revolutionscan/ScanRig_V.1.0/Pictures/_Main_comp_101275.png

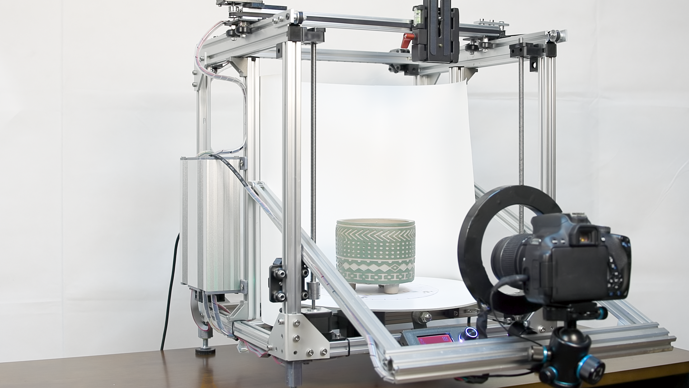
Pictures/_Main_comp_101275.png
