revolutionscan/ScanRig_V.1.0/README.md

# ScanRig_V.1.0
Open source files for photogrammetry rig.
