revolutionscan/ScanRig_V.1.0/Mechanical_Drawings/ScanRig_Front_v1.jpg

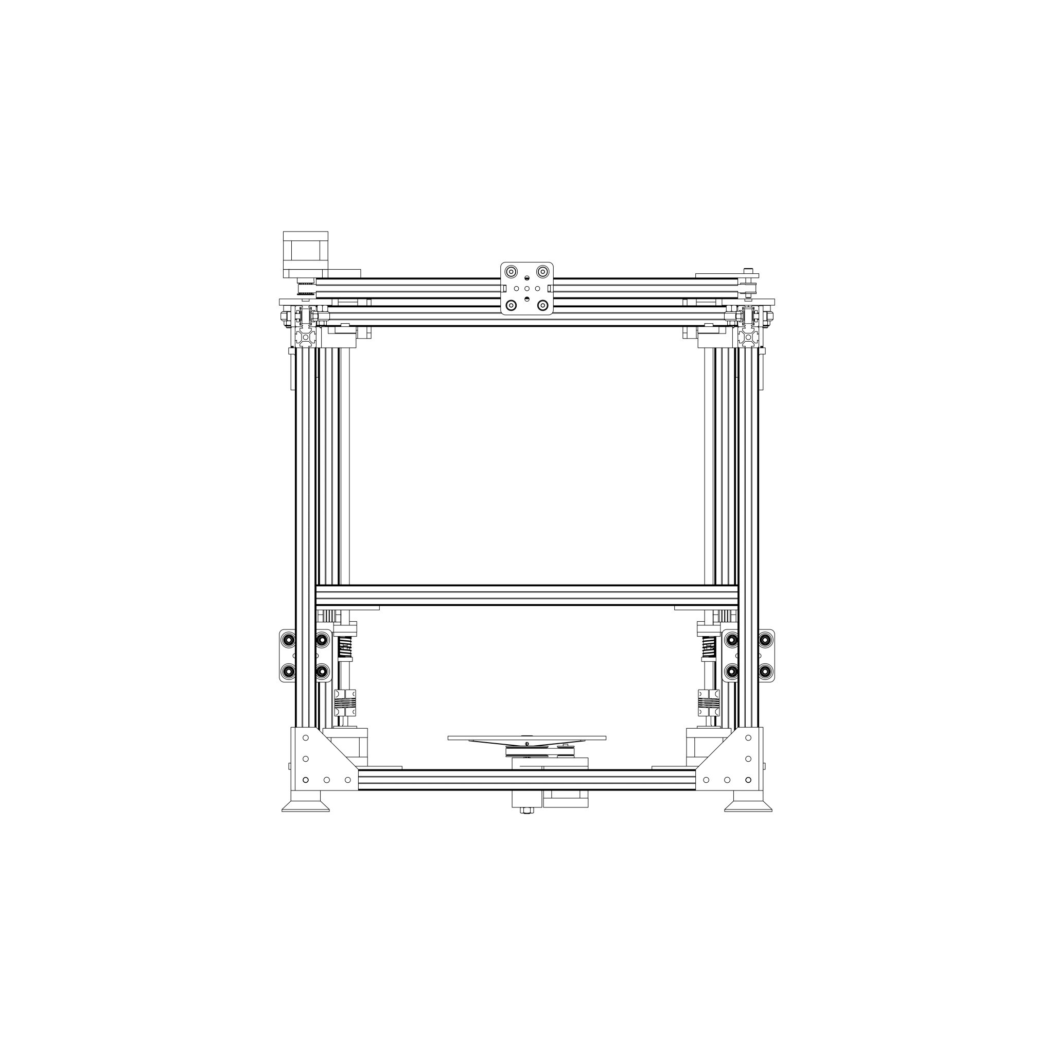
Mechanical_Drawings/ScanRig_Front_v1.jpg
