revolutionscan/ScanRig_V.1.0/Mechanical_Drawings/ScanRig_Top_v1.jpg

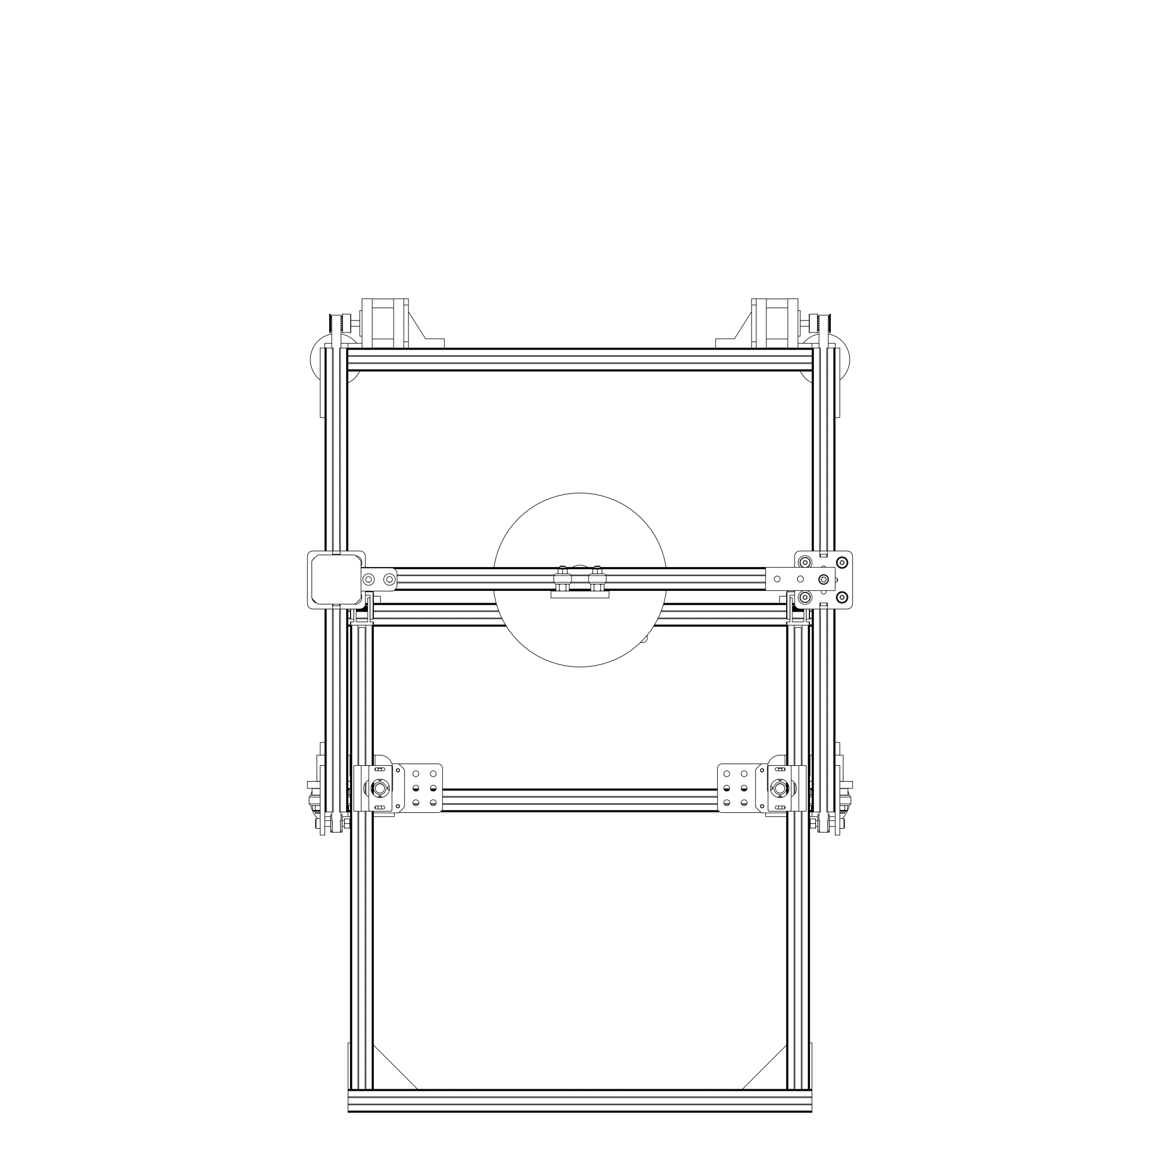
Mechanical_Drawings/ScanRig_Top_v1.jpg
