revolutionscan/ScanRig_V.1.0/Pictures/_Main_comp_1_01568.png

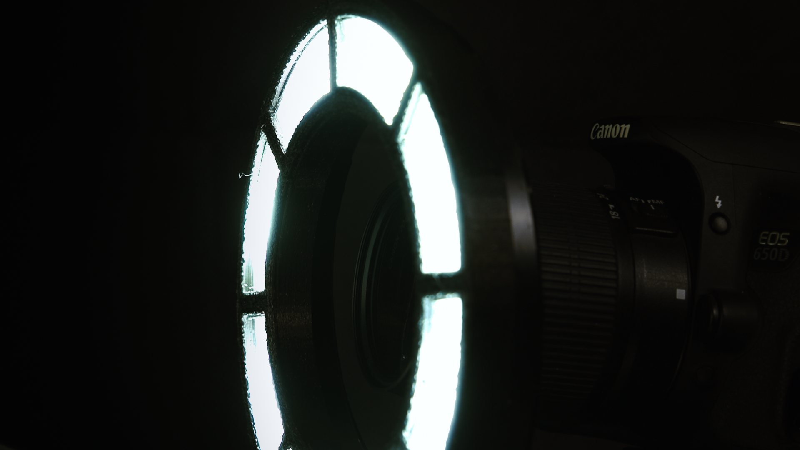
Pictures/_Main_comp_1_01568.png
