revolutionscan/ScanRig_V.1.0/Pictures/_Main_comp_100993.png

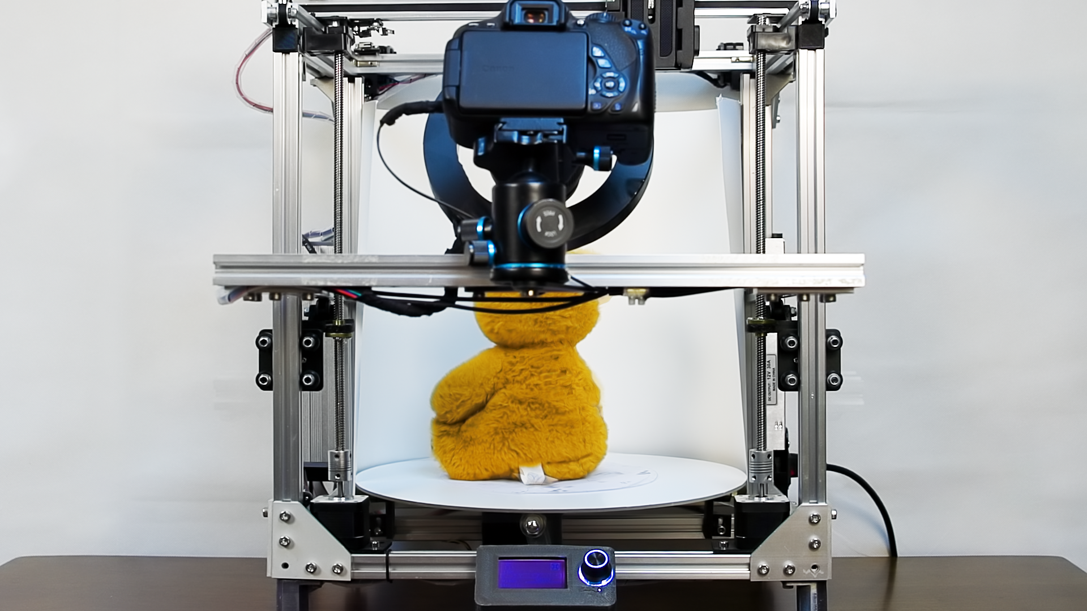
Pictures/_Main_comp_100993.png
