revolutionscan/ScanRig_V.1.0/Pictures/IMG_20240118_113210370.jpg

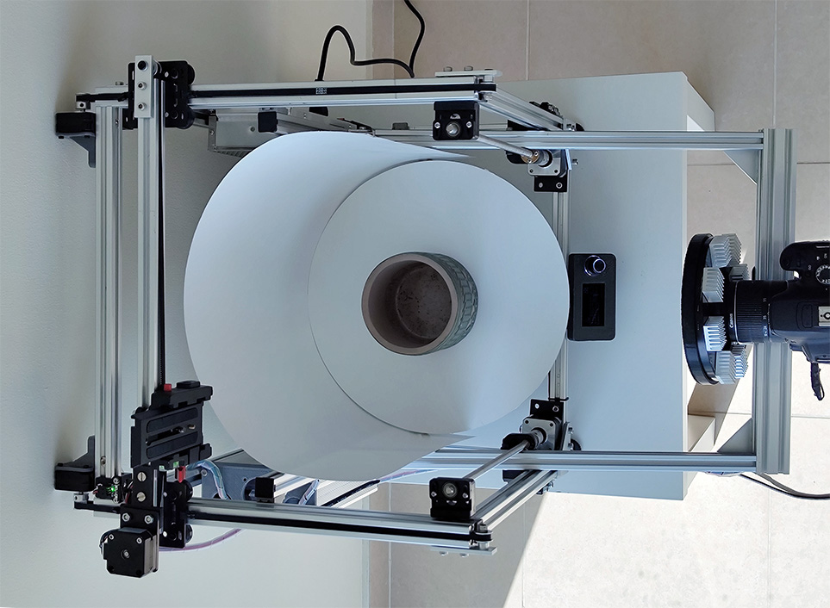
Pictures/IMG_20240118_113210370.jpg
