revolutionscan/ScanRig_V.1.0/Pictures/IMG_20240118_113330454.jpg

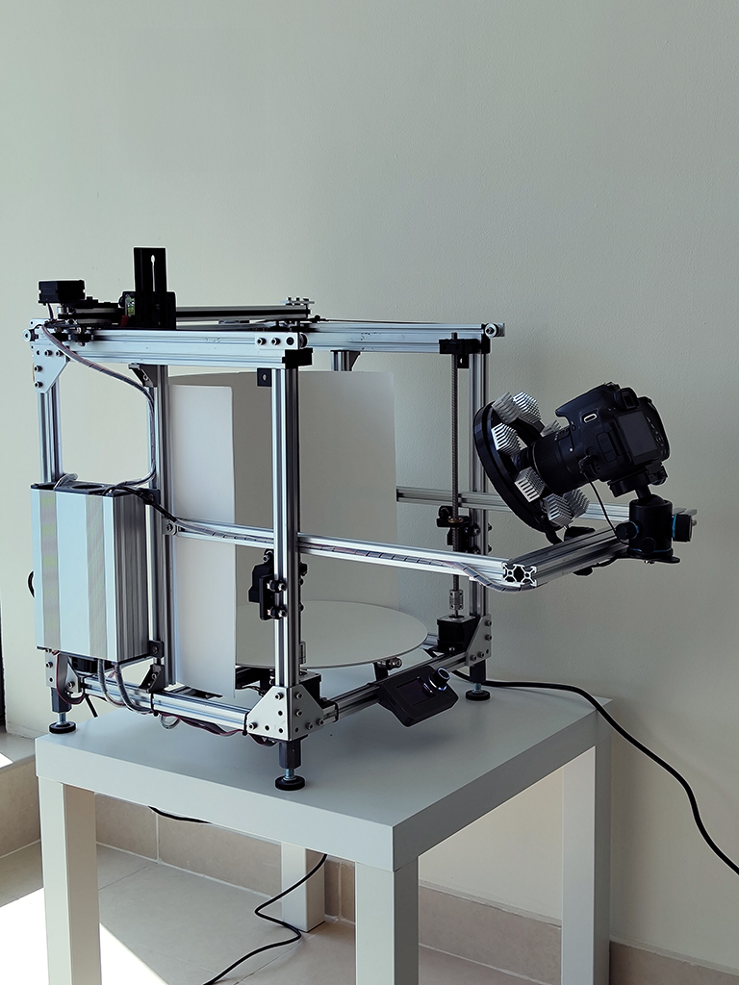
Pictures/IMG_20240118_113330454.jpg
