revolutionscan/ScanRig_V.1.0/ScanRig_BOM_v3.xlsx

Mechanics |  |  | Comment
2020 extrusion | 400mm | 16 | Missing one 2020 for 2.5D (Extrusion needs to be tapped for installing z axis pivot points) | https://www.aliexpress.com/item/1005004324352655.html | For the Z-axis camera arm, you might want to replace one 2020 with 2040 for extra rigidity for larger camera setups like with an AR400 flash.
2040 extrusion | 400mm | 2 |  | https://www.aliexpress.com/item/1005004324352655.html
2020 extrusion 5 hole 90 degree corner plate |  | 12 |  | https://www.aliexpress.com/item/1005004933978642.html
2020 corner bracket |  | 2 |  | https://www.aliexpress.com/item/1005001606267885.html
2020 inner corner bracket |  | 2 |  | https://www.aliexpress.com/item/4000795102417.html
2020 flexible pivot joint |  | 2 |  | https://www.aliexpress.com/item/1005004820583705.html
2020 nema 17 stepper motor mount |  | 2 |  | https://www.aliexpress.com/item/1005001860047581.html
2020 nema 17 stepper motor mount |  | 1 |  | https://www.aliexpress.com/item/1005001860047581.html
8 mm lead screw | 450mm | 2 |  | https://www.aliexpress.com/item/32970128435.html
8mm lead screw top mount |  | 2 |  | https://www.aliexpress.com/item/1005004359534458.html
5mm/8mm lead screw coupler |  | 2 |  | https://www.aliexpress.com/item/1005005114598745.html
2020 gantry plate wheel |  | 2 |  | https://www.aliexpress.com/item/1005001835688133.html
2020 gantry plate wheel |  | 3 |  | https://www.aliexpress.com/item/1005001835688133.html
CNC POM Wheel (big) + |  | 2 | For Z Carriage assembly | https://www.aliexpress.com/item/1005002846845515.html
GT2 timing pulley (bore 5mm, belt width 6mm, 20teeth) |  | 3 |  | https://www.aliexpress.com/item/1005004863292486.html
GT2 idler 20teeth 5mm |  | 3 |  | https://www.aliexpress.com/item/32822906447.html
GT2 timing belt | 5m | 1 | For clarification more than one meter is needed | https://www.aliexpress.com/item/32918948939.html
2020 Belt tensioner |  | 3 |  | https://www.aliexpress.com/item/1005004532578843.html
M5 T type insert | Pack 50 | 1 |  | https://www.aliexpress.com/item/32821764328.html
M5 sliding insert | Pack 50 | 1 |  | https://www.aliexpress.com/item/1005002114332413.html | Ball spring t-nuts are slightly more expensive but are MUCH easier to work than either the standard T-nuts or the hammerhead T-nuts, since they stay in place and can be inserted without having access to the open end of the extrusion:
M5 Machine Legs | Pack of 4 | 1 | Standoff legs for height adjustments and leveling | https://www.aliexpress.com/item/1005006793466745.htm
M5 Din 912 screw | 8mm | 24 | Added more M5 Screws 10(motors) + 3(endstops) + 8(legs) + 3(platform support) | https://www.aliexpress.com/item/32810872544.html
M5 Din 912 screw | 16mm | 8 | For attaching Z Carriage to gantry wheel plate
M5 Din 912 screw | 25mm | 3 | Added two for Z Carriage assembly wheel | https://www.aliexpress.com/item/32810872544.html
M5 Locking nut |  | 5 | For Z Carriage assembly wheel and platform support | https://www.aliexpress.com/item/1005006056776911.html
M8 Screw | 50mm | 1 | Rotary Assembly
M8 Screw | 20mm | 1 | Platform Support
M8 washer |  | 2 | Rotary Assembly
M8 Nyloc nut |  | 1 | Rotary Assembly
M3 Screw | 40mm | 24 | For attaching motor to NEMA Bracket
M3x14mm + nuts | 14mm | 12 | For attaching Z Carriage to lead screw
160-2GT-80Teeth Timing Belt | 160mm | 1 | Couldn't find a set with 160mm belt | https://www.aliexpress.com/item/32829827298.html
GT2 Timing Belt Pulley Bearing 20 & 60 Teeth 5mm 8mm Bore With 200mm Width 6mm Belt 1:3 Reduction |  |  | For Rotary Plate Assembly | https://www.aliexpress.com/item/1005005904948229.html
608Z Ball bearing | Pack 10 | 1 |  | https://www.aliexpress.com/item/1005006737960809.html
Electronics
Nema 17 stepper motor 42x42x38mm | 1.5A | 3 | Missing motor for rotary plate (2 for Z carriage + one for plate) | https://www.omc-stepperonline.com/e-series-nema-17-bipolar-0-9deg-30ncm-42-48oz-in-1-5a-42x42x38mm-4-wires-17me15-1504s
Nema 17 stepper motor 42x42x38mm | 1.5A | 3 |  | https://www.omc-stepperonline.com/e-series-nema-17-bipolar-0-9deg-30ncm-42-48oz-in-1-5a-42x42x38mm-4-wires-17me15-1504s
3d printer endswitches | pack of 3 | 1 |  | https://www.aliexpress.com/item/1005001834951972.html
Dual Z Axis splitter adapter |  | 2 |  | https://www.aliexpress.com/item/1005001792345071.html
Makerbase MKS Gen_L 2.1 Control Board |  | 1 |  | https://www.aliexpress.com/item/32802151924.html
TMC2209 Stepper motor driver (optional for silent operation) |  | 4 |  | https://www.aliexpress.com/item/1005005260961560.html
Power
LED power supply 12V/10A |  | 1 |  | https://www.aliexpress.com/item/33051556213.html
Buck converter 4-40V |  | 1 |  | https://www.amazon.com/EPLZON-Converter-Voltmeter-1-25-37V-Adjustable/dp/B09R49R76K
Mosfet module IRF520 |  | 2 |  | https://www.aliexpress.com/item/32836126224.html
Aluminum Enclosure 150*38*205mm Split Box PCB Silver OR |  |  | Box for electronics | https://www.aliexpress.com/item/1005005463240122.html
Aluminum Project Box Aluminum Cooling Box Aluminum Enclosure PCB Instrument Cooling Box Electronic Project Case 4*14*200mm |  |  | Alt Box for electronics | https://www.aliexpress.com/item/1005006534091460.html
Power Supply Mount |  |  |  | https://www.thingiverse.com/thing:2491547 | https://www.thingiverse.com/thing:3138130
Power supply outlet (depending on the type) |  |  |  | https://www.aliexpress.com/item/1005006361356458.html
Suggested Camera Mounts
DSLR Camera Tripod Ball Head |  |  |  | https://www.amazon.com/TH3-Capacity-U-Shaped-Switching-Vertical/dp/B00MGJH5U6/ref=sr_1_2
Bracket Extension Bar Flat or L Shaped |  |  | For mounting front camera | https://www.amazon.com/FANAUE-CQL-01-Universal-Compatible-Arca-Swiss/dp/B0CN4BQLRV/ref=sr_1_34
DSLR Camera L Bracket Vertical |  |  |  | https://www.amazon.com/Vertical-Horizontal-Switching-Compatible-Stabilizer/dp/B09RB11GK5/ref=sr_1_1
