revolutionscan/ScanRig_V.1.0/STL/3D_Scanner/Platform_assembly_v1.stl

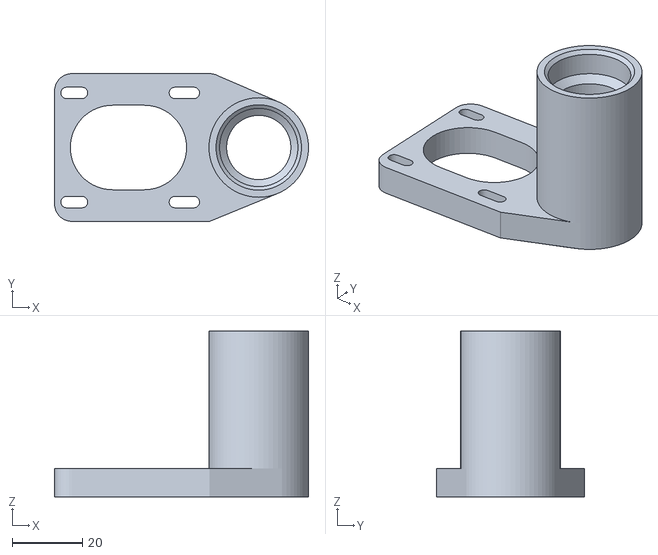
[picture p20: CAD file, 2024-03-21]
STL/3D_Scanner/Platform_assembly_v1.stl
72.1 x 42.0 x 47.0
