revolutionscan/ScanRig_V.1.0/STL/2.5D_Addition/X_motor_holder_v1.stl

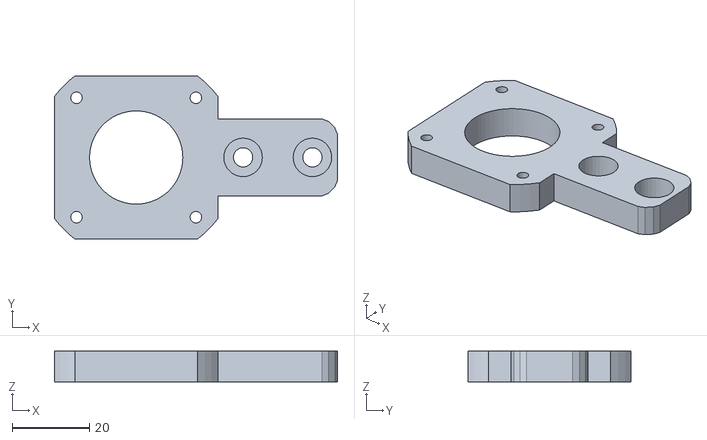
[picture p21: CAD file, 2024-03-21]
STL/2.5D_Addition/X_motor_holder_v1.stl
73.5 x 42.4 x 8.00
