revolutionscan/ScanRig_V.1.0/STL/3D_Scanner/Z_carriage_left_v1.stl

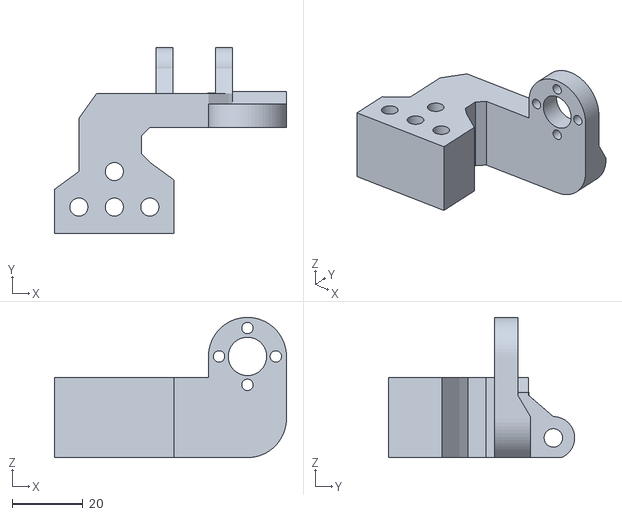
[picture p22: CAD file, 2024-03-21]
STL/3D_Scanner/Z_carriage_left_v1.stl
65.4 x 52.5 x 39.5
