revolutionscan/ScanRig_V.1.0/STL/Platform_Support_Right.stl

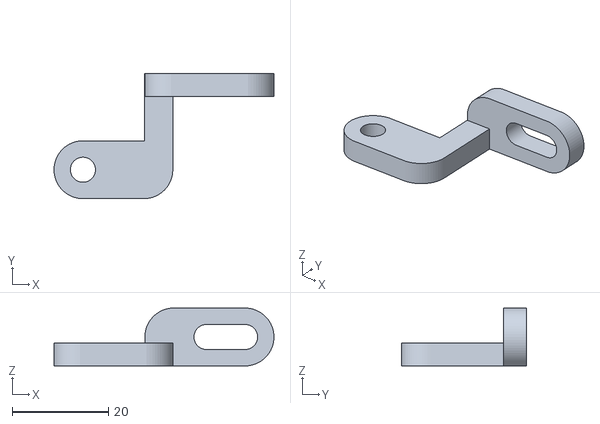
[picture p23: CAD file, 2024-08-19]
STL/Platform_Support_Right.stl
45.7 x 26.0 x 12.0
