revolutionscan/ScanRig_V.1.0/STL/2.5D_Addition/Y_motor_holder_x2_v1.stl

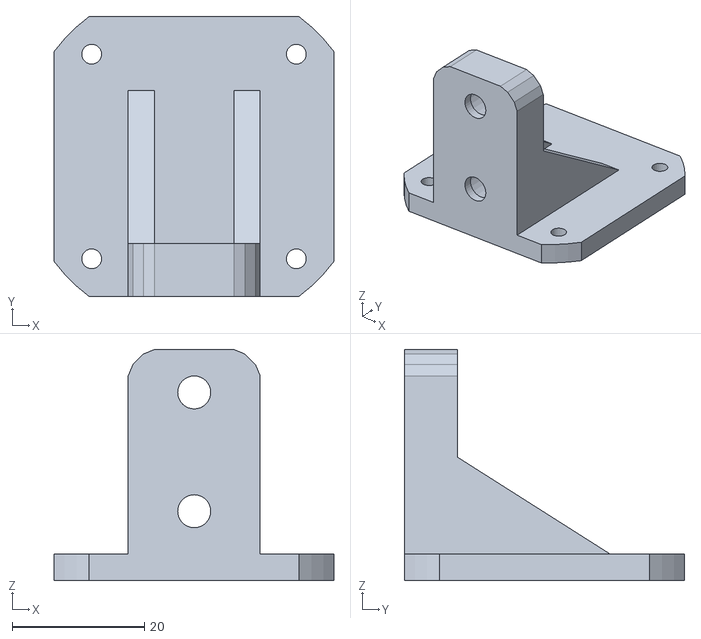
[picture p24: CAD file, 2024-03-21]
STL/2.5D_Addition/Y_motor_holder_x2_v1.stl
42.4 x 42.4 x 35.0
