revolutionscan/ScanRig_V.1.0/STL/3D_Scanner/Platform_carrier_v1.stl

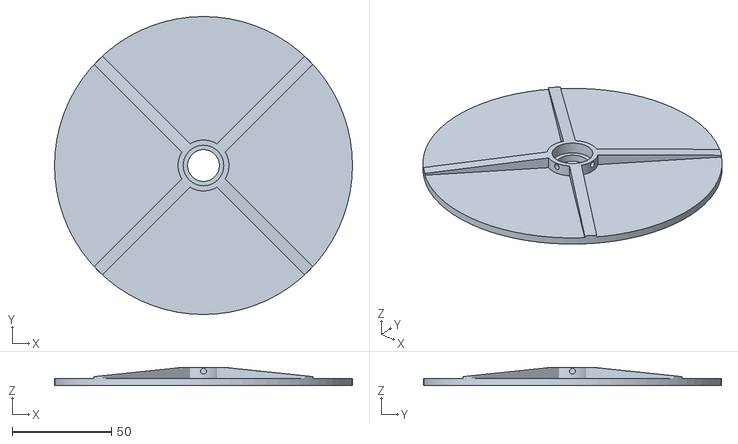
[picture p25: CAD file, 2024-03-21]
STL/3D_Scanner/Platform_carrier_v1.stl
150.0 x 150.0 x 9.30
