revolutionscan/ScanRig_V.1.0/STL/End_Stop_Switch_Holder.stl

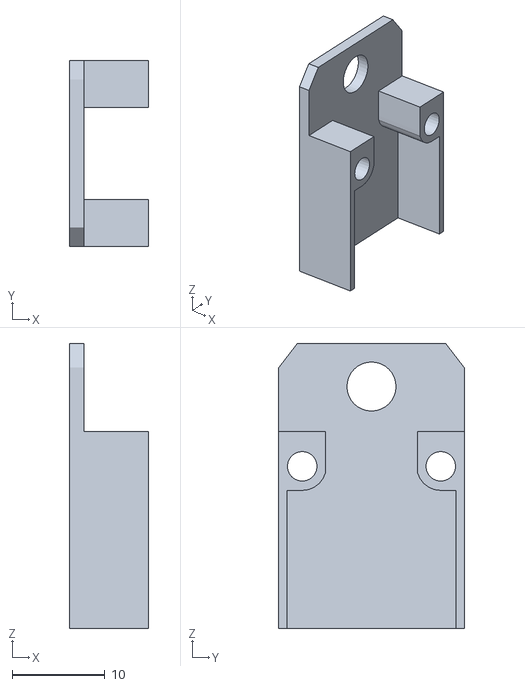
[picture p26: CAD file, 2024-08-19]
STL/End_Stop_Switch_Holder.stl
8.55 x 20.0 x 30.8
