revolutionscan/ScanRig_V.1.0/STL/Platform_Support_Front.stl

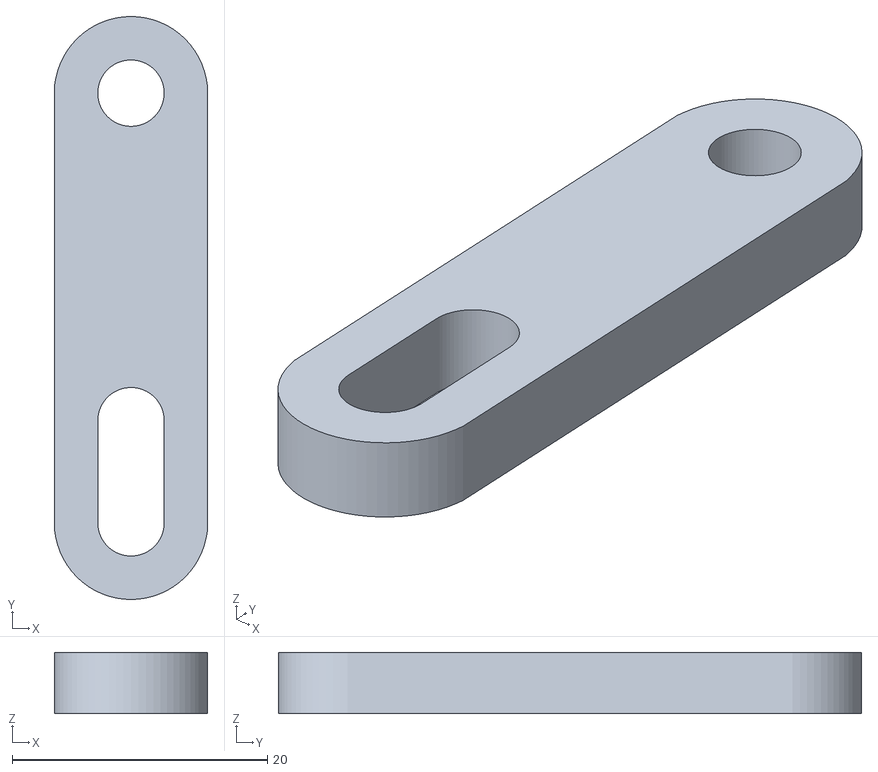
[picture p27: CAD file, 2024-08-19]
STL/Platform_Support_Front.stl
12.0 x 45.7 x 4.80
