revolutionscan/ScanRig_V.1.0/(list of files, cad)

Other CAD files:
STL/3D_Scanner/Z_carriage_right_v1.stl
STL/Platform_Support_Left.stl
