revolutionscan/ScanRig_V.1.0/(threads)

Thread 1 (2024-08-02):

More accurate BOM QTYs to avoid confusion

Packabilly, 2024-08-02:
Hi, my shipment of parts came today; I'm really excited to build my rig. However when I began assembly, I noticed I had made some errors when ordering parts due to confusion caused by the BOM referencing the quantities listed in the Aliexpress links instead of the true total part quantities.

For example, the 'inner corner bracket' QTY is listed as '2', but that references the Ali link QTY of 5pcs, so the true total QTY would be 10. The same for the corner brackets and the M5 screws.

It's not a huge deal if you read and understand the BOM and review the CAD properly, but I think changing to total QTYs would make it easier for dummies like me to understand and self-source parts, as well as prevent future issues caused by broken links.

Thanks or the awesome project; I can't wait to get it up and running!

revolutionscan, 2024-08-02:
Hi,
thank you for letting me know. I will update the BOM to avoid further
confusion.

Please share any images and if you need any assistance I'll be happy to
help you out.

Thanks!

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

Links:
------
[1] https://github.com/revolutionscan/ScanRig_V.1.0/issues/1
[2]
https://github.com/notifications/unsubscribe-auth/BHEKZ3BVWHBVWLBEY64KAX3ZPNAA3AVCNFSM6AAAAABL4DAN5GVHI2DSMVQWIX3LMV43ASLTON2WKOZSGQ2DINBQGI3TMOI

Thread 2 (2024-08-17):

My build experience: issues and suggestions

Packabilly, 2024-08-17:
Hey again! Firstly I just wanted to say thank you for the work you've done on the project thus far; there is nothing else like this out there and I hope you continue to develop and refine it. I hope my experiences below don't give the impression of complaining, I just want to offer my experience in the most constructive manner I can. Hopefully this helps improve the project or at least help other users avoid some pitfalls.

 I've started my build and progressed as far as possible and have encountered a few issues which I've noted along with a couple of suggestions to make the build process a little more straightforward. I've listed the critical stuff first to simplify it (sorry if the format is hard to read):

------------------------------------------------------------------------------------------------------------------------------------------
### Critical stuff that stop the build in it's tracks (I had a few things on hand but most users won't)- Missing/unclear BOM parts and STLs:

- Missing 2x smooth POM wheel and 2x Nyloc nuts from z-axis assembly;

These are crucial to the build but not listed in BOM

- Extrusion needs to be tapped for installing z axis pivot points;

This was an unforeseen issue, but something that should be made clear. I ended up using J-B Weld metal to epoxy them in place instead.

- Leadscrew brass nut screws did not self-tap like shown in guide;

I used M3x14mm + nuts to attach to printed assembly

- Attaching motors using NEMA mount plates needs M3x40 to attach securely;

Build guide shows long countersunk screws used, but would be better/easier to order M3x40 with the rest of the parts

- Missing M5x16 to attach gantry wheel plate to z-axis assembly;

Critical to the build and need to be the exact length to avoid interfering with the "gantry plate wheel"

- Missing motor for 2.5D;

Build guide implies 2x Y-Motors are used, but BOM only lists 5x motors, but 6 are needed: Y= 2x, X= 1x, Z= 2x, Rot= 1x

- Missing 2020 for 2.5D;

15x 2020 is one short. I ended up ordering an additional 2040 instead for the camera arm for extra rigidity

- Missing GT2 60 tooth pulley, 20 tooth pulley and belt + fasteners (M8x60 bolt, 2x flat washers, 1x split washer and 1x nut);

Critical to build, but not listed in BOM

- Missing STLs & BOM for legs/feet;

Critical to build, since the platform motor is mounted below the bottom extrusions

- Missing files for endstops

Critical to build

- STLs missing for platform supports +Nyloc nuts missing from BOM

Critical to build if you want to utilize the entire frame fro the platform

- BOM only lists 1M of GT2 timing belt

Critical to build if using 2.5D, since you'll need 3x lengths: 2x for Y and 1x for X. It would be simpler to add a total belt length for users to order and cut themselves

- Missing LCD from BOM and STL for mount

Critical for build since it provides an interface. I personally am going to use Klipper to interface via Weeb browser, but the average user will likely use an LCD.

- Missing links/STL for compatible camera carriers

Critical for build since there are many options for mounts out there. I personally have no idea what to use here.

- Missing STL/link for electronics enclosure and PSU mount

Critical to build and also for user safety. Without a mount, the PSU will have exposed mains wiring which is obviously pretty dangerous.

- Missing STL/link for electronics enclosure

Critical to build since the mainboard needs to be mounted in some way to prevent shorts on the metal frame.

- Missing M5x8 screws;

BOM lists 50x, which is just enough  to build the frame but not mount the motors

------------------------------------------------------------------------------------------------------------------------------------------
### Non-critical stuff that won't stop the build but may cause confusion:

- Missing 2x corner brace blocks from top-front extrusions;

These are shown in CAD and build guide but missing from BOM. I assume these are to be replaced  by "2020 inner corner bracket", but it stumped me at first.

- Linked corner brackets have alignment nubs that prevent them mounting flush with extrusions (for the z-axis pivot points);

I ground these flat with a Dremel tool so they sit flush

- Gantry wheel plate hole orientation doesn't match ali link, so is less rigid;

The X gantry wheel plate in the build guide has an extra hole closer to the belt mount points, but the linked ones do not. Not a big deal, but it may cause the X gantry to twist easier

------------------------------------------------------------------------------------------------------------------------------------------
### Suggestions to make the process simpler:

- Separate BOM section for 2.5D would help clarify;

Adding a separate section for the 2.5D components would make it ore clear to the user what is required and let them decide if they need/want 2.5D or just the Z-axis + rotary platform

- Add option to replace t-nuts with ball spring T-Nuts;

Ball spring t-nuts are slightly more expensive but are MUCH easier to work than either the standard T-nuts or the hammerhead T-nuts, since they stay in place and can be inserted without having access to the open end of the extrusion: https://www.aliexpress.com/item/1005003678960619.html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

- Add option to replace z-axis 2020 with 2040

For the Z-axis camera arm, it would be nice to offer the option to use 2040 instead of the BOM 2020 for extra rigidity for larger camera setups like with an AR400 flash.

------------------------------------------------------------------------------------------------------------------------------------------
### Extra stuff that should be in the BOM (this is not an exhaustive list, just what I can remember and have noted during my build):

- M3x14 =                x 4 (Rotary plate motor mount) + 4-8 (Leadscrew brass nut mount)
- M3 Nuts=              x 4-8 (Leadscrew brass nut mount)

- M5x8 =                   x 24 = 10(motors) + 3(endstops) + 8(legs) + 3(platform support)

- M8x50 =                 x 1 (Rotary assembly)
- M8 Nyloc nut=       x 1 (Rotary assembly)
- M8 washer=           x 2 (Rotary assembly)
- 60t GT2 pulley=     x 1 (Rotary assembly)
- GT2 belt loop=       x 1 (Rotary assembly)

- M8x20 =                 x 3 (platform support)
- M5 Nyloc nuts=     x 3 (platform support)

- POM wheel=           x 2 (Z-axis assembly)

-

revolutionscan, 2024-08-19:
Thank you very much for flagging these, it's much appreciated. I uploaded new BOM (v.3) https://github.com/revolutionscan/ScanRig_V.1.0/blob/main/ScanRig_BOM_v3.xlsx

Some things remain unaddressed:
- Missing LCD from BOM and STL for mount
LCD interaction is still in development so, final LCD screen with controls is not included in the BOM. Current MKS GEN L Board users can rely on MINI12864 LCD https://biqu.equipment/products/bigtreetech-mini12864-v2-0-lcd-screen-rgb-backlight-mini-display-supports-marlin-diy-for-skr-3d-printer-part-1
Printable case for V slot: https://www.printables.com/model/56150-mini-12864-lcd-display-housing-for-2020-v-slot

- Missing links/STL for compatible camera carriers
I have included some links for carriers that will work with V slot extrusions for DSLR camera, but this will depend on the users choices

- Separate BOM section for 2.5D would help clarify
It's a bit hard to separate these, as certain parts overlap. I will try to make into different sections.

revolutionscan, 2024-08-19:
Missing STL's for switches and platform support have been uploaded to the STL section:
https://github.com/revolutionscan/ScanRig_V.1.0/tree/main/STL

revolutionscan, 2024-08-20:
Timing Belt length for the Rotary section should be 16cm, not 20cm as marked and linked in BOM. Excel sheet has been updated.

Thread 3 (2024-09-05):

No STL files of led ring.

thainq3127, 2024-09-05:
Hi, thank you for sharing this awesome project. I just finished building a 70x70x70 rig, then I notice there is no STL files of led ring. I found some on thingverse but they don't support polarizing filter. Could you please upload yours to the repo.

Thread 4 (2024-10-09):

Wiring diagram and instruction for code installation

anthonycorns, 2024-10-09:
I'm just about to start my construction of a ScanRig and have checked over the instructions several times to make sure I don't miss anything.

There are a few areas I'm unsure about and any help would be appreciated.

- Do you have a wiring diagram on where each of the following components should be attached on the MKS_GEN_L_V2 board?

1. Camera Shutter cable
2. 2.5D Lights
3. 3D Ring light
4. Each of the stepper motors and associated end-switches, including Dual Z Axis splitter
5. MKS Mini12864 V3 LCD Smart Display Screen

I know you are still working on a ring light design. It would be good to build this with both unpolarised and polarised lights. Currently I have a setup with an turntable and Godox AR400 ring flash with Pol Filter and I capture both cross polarised and normal lighting images by rotating a cross polarising filter on the lens. It would be great in the ScanRig captured two images for each setup one with normal lights and one with cross polarised built into the same ring lights, so they can be used to generate roughness and specular texture maps (you can see an example [here](https://sketchfab.com/3d-models/fragment-sp1b-of-kinale-shrine-ee8aa77aa7864ccfb4397d514eb0c913) from a recent artefact recorded)
