revolutionscan/ScanRig_V.1.0/(commit log)

2024-03-20 Add files via upload
    Marlin 2.0 modification to enable independent brightness control of multiple LEDs via pin 41. To be used for separate intensity control of each LED in the light ring.
2024-03-21 Add files via upload
    CAD model of mechanical assemblies
2024-03-21 Add files via upload
    Printable STL files
    [Platform_assembly_v1.stl, Platform_carrier_v1.stl, X_motor_holder_v1.stl, Y_motor_holder_x2_v1.stl, Z_carriage_left_v1.stl, Z_carriage_right_v1.stl]
2024-03-21 Add files via upload
    Drawings of mechanical assembly
2024-08-19 Add files via upload
    Comprehensive changes to the BOM as some users noticed there are certain parts missing, mainly on Z carriage and the rotation platform.
    Many thanks to https://github.com/Packabilly for flagging them https://github.com/revolutionscan/ScanRig_V.1.0/issues/2
    [ScanRig_BOM_v3.xlsx]
2024-08-20 Add files via upload
    Updated timing belt length for the Rotary section should be 16cm, not 20cm as marked and linked in BOM. Excel sheet has been updated.
    [ScanRig_BOM_v3.xlsx]
